Kosana66/Automobil-koji-izbegava-prepreke/Prezentacija.pptx

## Tenk koji izbegava prepreke

Studenti:
Anja Vračarić EE158/2019
Lazar Đurić EE238/2019
Aleksandar Rakić EE103/2019
Kosana Pavlović EE43/2019

Mentori:
Prof. Dr Vladimir Rajs
MSc. Marko Vasiljević – Toskić
MSc. Milan Bodić

## Slide 2

- PCB pločica u završnom stadijumu

- Jezgro sistema: mikrokontroler DSPIC30F4013
- Periferije: - Bluetooth (HC-06) i UART modul - Digitalni senzor HC-SR04 - Analogni sharp senzor - Drajver L298N - DC motori sa četkicama
- Terminal

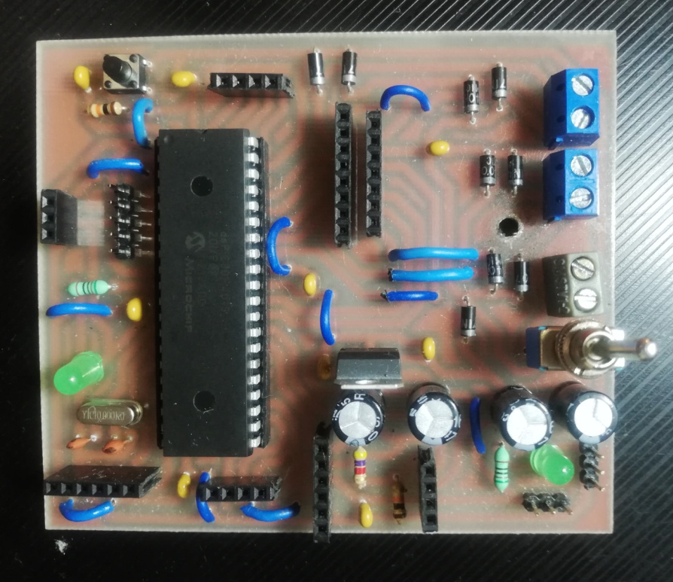
[picture p15: figure]

## Slide 3

- ¤ izbegavanje prepreka sa prednje strane i sa bočnih strana
- ¤ START  ¤ konstantna merenja sa senzora
- ¤ rastojanje 15cm
- ¤ povećanje i smanjenje brzine obrtanja gusenica putem tastature


## Slide 4

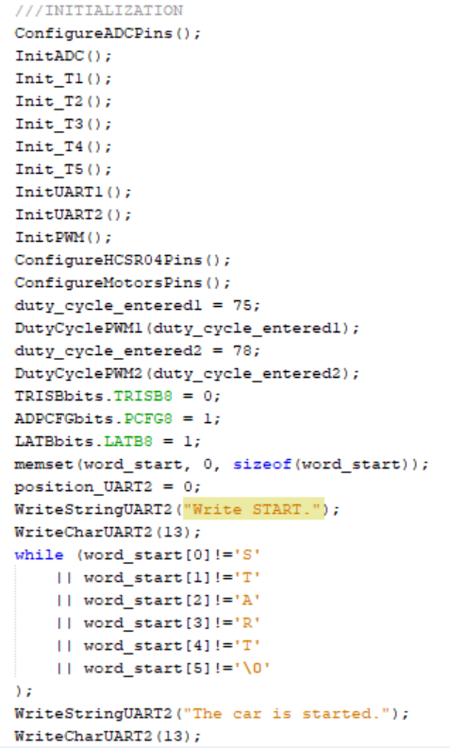
[picture p16: figure]

## Slide 5

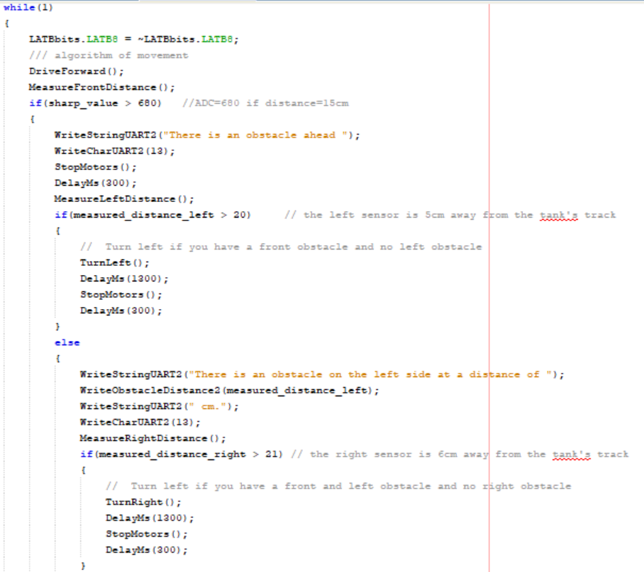
[picture p17: figure]

## Slide 6

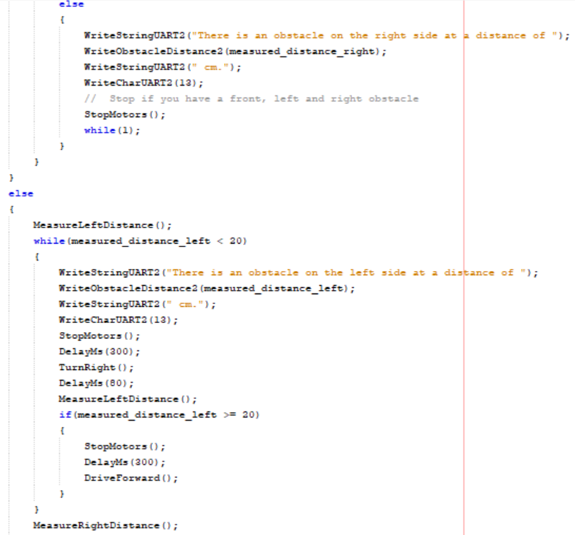
[picture p18: figure]
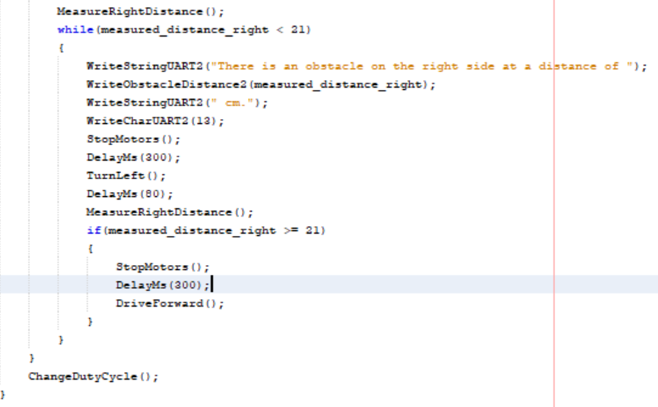
[picture p19: figure]

## PWM signali za motore

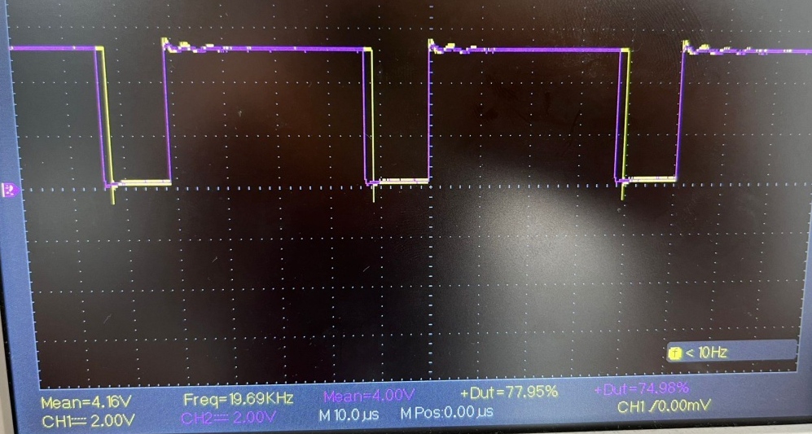
[picture p20: figure]

- pri pokretanju tenka

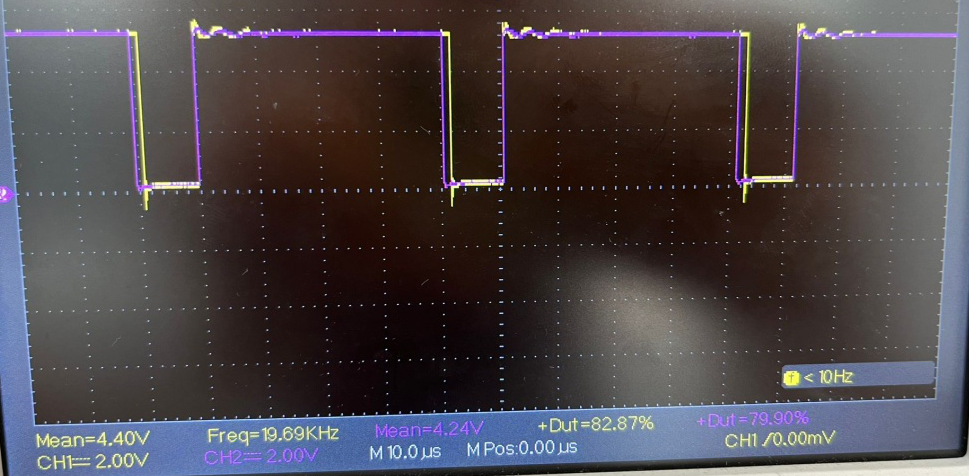
[picture p21: figure]

- nakon pritisnutog + tastera na tastaturi

## PWM signali za motore

- pri pokretanju tenka

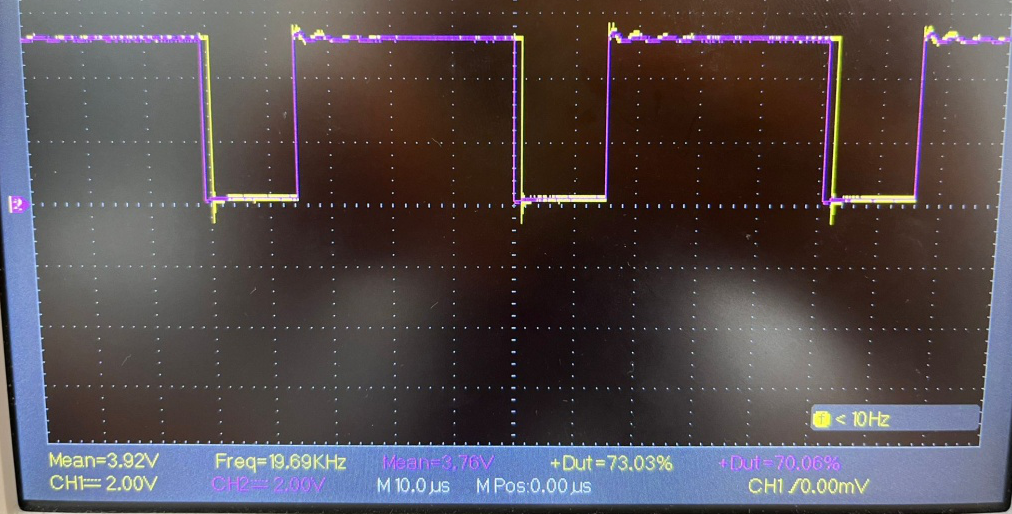
[picture p22: figure]

- nakon pritisnutog - tastera na tastaturi

## Moguća poboljšanja

- problemi pri izradi PCB pločice
- korišćenje prekidne rutine umesto while petlje kod digitalnih senzora
- korišćenje žiroskopa i PID regulacije za skretanje i održavanje distance od 15cm

## Moguća poboljšanja

- više senzora na različitim pozicijama kako bi se pokrili svi uglovi tenka
- drugi analogni senzor zbog nemogućnosti detekcije svetlih i providnih prepreka
- algoritam za praćenje ivice ili praćenje putanje

## Hvala na pažnji !
