Kosana66/Automobil-koji-izbegava-prepreke/(list of files, drawings)

Other design files:
Projektovanje plocice u Altiumu/drajver.SchLib
Projektovanje plocice u Altiumu/dspic30f4013.PcbLib
Projektovanje plocice u Altiumu/kond.PcbLib
Projektovanje plocice u Altiumu/konektor_2.pcblib
Projektovanje plocice u Altiumu/konektor_3.pcblib
Projektovanje plocice u Altiumu/l298n.PcbLib
Projektovanje plocice u Altiumu/oscilator.PcbLib
Projektovanje plocice u Altiumu/PCB.PcbDoc
Projektovanje plocice u Altiumu/PCBv2.PcbDoc
Projektovanje plocice u Altiumu/prekidac.PcbLib
Projektovanje plocice u Altiumu/res.PcbLib
Projektovanje plocice u Altiumu/rsens.PcbLib
Projektovanje plocice u Altiumu/schematic.SchDoc
Projektovanje plocice u Altiumu/Schlib1.SchLib
Projektovanje plocice u Altiumu/stabilizator.PcbLib
Projektovanje plocice u Altiumu/taster.PcbLib
Projektovanje plocice u Altiumu/Zadatak 2.PrjPcb
Projektovanje plocice u Altiumu/zelena_led.PcbLib
