Kosana66/Automobil-koji-izbegava-prepreke/Firmware.X/uart_module/uart.c

/* 
 * File:   uart.c
 * Author: kosana
 *
 * Created on 03.05.2023., 21.27
 */

#include <p30fxxxx.h>

/// Header file for UART
#include "uart.h"

/* 
 * @brief - Function for iniializing UART1
 * @param None
 * @return None
 */
void InitUART1(void)
{
    /// U1BRG = (Fcy / (16 * Baudrate) - 1
    U1BRG=0x0040;           /// Baudrate = 9600, Fcy = 10MHz, U1BRG = 40
    U1MODEbits.ALTIO=1;     /// 1 = alternative UART1 pins is used
    IEC0bits.U1RXIE=1;      /// 1 = enabled RX interupt for UART1
    U1STA&=0xfffc;          /// Setting the last 2 bits on 0 (bit for data signaling, bit for error)
    U1MODEbits.UARTEN=1;    /// 1 = enable UART1 module
    U1STAbits.UTXEN=1;      /// 1 = enabled TX for UART1
}

/* 
 * @brief - Function for writing one character over UART1
 * @param data - The character being sent
 * @return None
 */
void WriteCharUART1(unsigned int data)
{
    while(!U1STAbits.TRMT);         /// Waiting for the transmit register to be available
    if(U1MODEbits.PDSEL == 3)       /// 9-bit data without parity bit
        U1TXREG = data;
    else
        U1TXREG = data & 0xFF;
}

/* 
 * @brief - Function for writing string over UART1
 * @param str - The character being sent
 * @return None
 */
void WriteStringUART1(register const char *str)
{
    while((*str)!=0)
    {
        WriteCharUART1(*str);
        if(*str == 10)
            WriteCharUART1(13);
        if(*str == 13)
            WriteCharUART1(10);
        str++;
    }
}

/* 
 * @brief - Function for writing a four-digit number over UART1
 * @param data - The number being sent
 * @return None
 */
void WriteUART1dec2string(unsigned int data)
{
    unsigned char temp;
    temp=data/1000;
    WriteCharUART1(temp+'0');  
    data=data-temp*1000;
    temp=data/100;
    WriteCharUART1(temp+'0');
    data=data-temp*100;
    temp=data/10;
    WriteCharUART1(temp+'0');
    data=data-temp*10;
    WriteCharUART1(data+'0');
}

/* 
 * @brief - Function for iniializing UART2
 * @param None
 * @return None
 */
void InitUART2(void)
{
    /// U2BRG = (Fcy / (16 * Baudrate) - 1
    U2BRG=0x0040;           /// Baudrate = 9600, Fcy = 10MHz, U2BRG = 40
    IEC1bits.U2RXIE=1;      /// 1 = enabled RX interupt for UART2
    U2STA&=0xfffc;          /// Setting the last 2 bits on 0 (bit for data signaling, bit for error)
    U2MODEbits.UARTEN=1;    /// 1 = enable UART2 module
    U2STAbits.UTXEN=1;      /// 1 = enabled TX for UART2
}

/* 
 * @brief - Function for writing one character over UART2
 * @param data - The character being sent
 * @return None
 */
void WriteCharUART2(unsigned int data)
{
    while(!U2STAbits.TRMT);         /// Waiting for the transmit register to be available
    if(U2MODEbits.PDSEL == 3)       /// 9-bit data without parity bit
        U2TXREG = data;
    else
        U2TXREG = data & 0xFF;
}

/* 
 * @brief - Function for writing string over UART2
 * @param str - The character being sent
 * @return None
 */
void WriteStringUART2(register const char *str)
{
    while((*str)!=0)
    {
        WriteCharUART2(*str++);
    }
}

/* 
 * @brief - Function for writing a four-digit number over UART2
 * @param data - The number being sent
 * @return None
 */
void WriteUART2dec2string(unsigned int data)
{
    unsigned char temp;
    temp=data/1000;
    WriteCharUART2(temp+'0');  
    data=data-temp*1000;
    temp=data/100;
    WriteCharUART2(temp+'0');
    data=data-temp*100;
    temp=data/10;
    WriteCharUART2(temp+'0');
    data=data-temp*10;
    WriteCharUART2(data+'0');
}

/* 
 * @brief - Function for writing a distance from obstacle over UART2
 * @param data - The distance being sent
 * @return None
 */
void WriteObstacleDistance2(float data)
{
    unsigned char temp;
    data = data*10;
    temp=data/10000;
    WriteCharUART2(temp+'0');  
    data=data-temp*10000;
    temp=data/1000;
    WriteCharUART2(temp+'0');
    data=data-temp*1000;
    temp=data/100;
    WriteCharUART2(temp+'0');
    data=data-temp*100;
    temp=data/10;
    WriteCharUART2(temp+'0');
    WriteCharUART2('.');
    data=data-temp*10;
    WriteCharUART2(data+'0');
}
