Kosana66/Automobil-koji-izbegava-prepreke/(commit log)

2023-03-30 Prva verzija schematic-a
    [Schlib1.SchLib, Zadatak 2.PrjPcb, schematic.SchDoc]
2023-04-05 Modifikovan schematic i dodati footprint-ovi bez 3D modela
    [drajver.SchLib, dspic30f4013.PcbLib, konektor_3.pcblib, konektor_f.pcblib, l298n.PcbLib, oscilator.PcbLib, prekidac.PcbLib, rsens.PcbLib]
2023-04-05 Modifikovan schematic, dodati footprint-ovi bez 3D modela i prva verzija PCB-a
    [PCB.PcbDoc, Zadatak 2.PrjPcb]
2023-04-11 Modifikovani footprint-ovi, povezani Rsense na analogne pinove, pocetak rutiranja
    [PCB.PcbDoc, Zadatak 2.PrjPcb, dspic30f4013.PcbLib, kond.PcbLib, konektor_3.pcblib, konektor_f.pcblib, l298n.PcbLib, oscilator.PcbLib]
2023-04-17 Dodati header-i kod rsense otpornika, druga verzija PCB-a
    [PCB.PcbDoc, Zadatak 2.PrjPcb, kond.PcbLib, konektor_2.pcblib, oscilator.PcbLib, prekidac.PcbLib, res.PcbLib, rsens.PcbLib]
2023-04-30 Gotov PCB spreman za izradu
    [PCB.PcbDoc]
2023-05-03 Code template. Added UART, ADC and Timers with documentation
2023-05-22 Timer 1/2 and UART 1/2 have been implemented correctly.
    [newmain.c]
2023-05-29 Implemented functions of pwm module and HCSR04 sensors
2023-06-03 Implemented HCSR sensor functionality using functions with while instead of ISR
2023-06-11 Added new PCB
    [PCB.PcbDoc, PCB_konvertor.PrjPcb, PCB_konvertora.PcbDoc, PCBv2.PcbDoc, Sheet1.SchDoc, schematic.SchDoc]
2023-06-19 Needed implementation of algorithm
    [PCB_konvertor.PrjPcb, PCB_konvertora.PcbDoc, Sheet1.SchDoc]
